wobscale/pirack/(threads)

Thread 4 (2018-01-05):

Digikey BOM

LinuxMercedes, 2018-01-05:
Avoid BGA parts since we don't have that fancy of a soldering setup!
