wobscale/pirack/(commit log)

2017-07-30 Fix formatting; add some more power supplies
2017-08-02 Switch chip eval board datasheet + schematics
2017-08-02 Pi GPIO pin assignments and other shit
2017-08-02 RGMII docs; probably not needed but they were nontrivial to track down
2017-08-03 CM3L + DDR slot dimensions
2017-08-04 LAN9512 component schematic
2017-08-06 Silkscreen todos
2017-08-07 Datasheets on decoupling capacitors and lan9512 eval board
2017-08-07 Deduplicate power pins and hide NC pins
2017-08-07 Power schematics for one CM3L and one LAN9512
    [poc.kicad_pcb, poc.sch]
2017-08-07 Temp sensor stuff
2017-08-07 Update functional block diagram with temp sensors and RST switch line
2017-08-08 More datasheet/digikey spelunking...now have UARTs and whatnot
2017-08-08 Update functional block diagram with SPI UART
2017-08-08 Done with power layout for top cm3l
    [poc.sch]
2017-08-09 Temp sensor component
2017-08-09 Update IO pin counts for mgmt ic
2017-08-10 Add Atmel SAM4E schematic
2017-08-10 Add TI DP83867 schematic
2017-08-10 Switch ic schematic
2017-08-10 MGMT IC IO Pin info and programming info
2017-08-12 Some new schematics and some deduplication of pins
2017-08-12 Move CM3L into hierarchical sheet
    [poc.sch, top-pi.sch]
2017-08-13 Add one switch chip and power for things
    [poc.sch, switches.sch, top-pi.sch]
2017-08-13 Power for a gige phy
    [switches.sch]
2017-08-13 Further organize pi schematics; power for each chip is done!
    [Bank1.sch, poc.sch, switches.sch, top-pi.sch]
2017-08-19 Add SAM4E footprint
    This is merely a version of [1] rotated to match the datasheet.
    [1]: https://github.com/KiCad/Housings_QFP.pretty/blob/bead92b12bc7bce0a9bca07796d0ba4a9c53bdc2/LQFP-144_20x20mm_Pitch0.5mm.kicad_mod
2018-01-08 Finish LAN9512 USB layout
    [Bank1.sch, poc.sch, switches.sch, top-pi.sch]
2018-01-08 LAN9512 JTAG header
    [top-pi.sch]
2018-01-08 LAN9512 Misc. Pins (LEDs, GPIO, etc)
    Of note, we're enabling Auto-MDIX; strictly, this shouldn't be
    necessary, but I feel we're better safe than sorry.
    I've left a note to route a GND connect nearby so we can switch
    it off if need be.
    [top-pi.sch]
2018-01-08 LAN9512 Ethernet wiring
    [Bank1.sch, top-pi.sch]
2018-01-08 Disable Auto-MDIX instead
    On second thought, auto-MDIX probably just complicates things.
    The pin next to it is tied to 3v3, so if we really need it we can bodge
    in a pull-up resistor relatively easily.
    [top-pi.sch]
2018-01-08 LAN9512 EEPROM pins
    [top-pi.sch]
2019-09-15 Upgrade to newer kicad
    [Bank1.sch, poc.sch, switches.sch, top-pi.sch]
2019-09-15 wire SD card to cm3l
    [Bank1.sch, switches.sch, top-pi.sch]
2019-09-15 CM3L GPIO pins: only 14/15 for UART
    [top-pi.sch]
2019-09-15 Remaining CM3L pins, incl. jtag header
    [top-pi.sch]
2019-09-15 Add hierarchical labels to parent schematic
    [Bank1.sch]
2019-09-16 Add note about power switching for CM3L/LAN9512
